joao-tecnico-chad/SCDTR-project/Distributed Controller/report/report_phase2.tex

\documentclass[10pt,twocolumn]{article}

\usepackage[utf8]{inputenc}
\usepackage[margin=1.8cm]{geometry}
\usepackage{graphicx}
\usepackage{amsmath,amssymb}
\usepackage{booktabs}
\usepackage{caption}
\usepackage{hyperref}
\usepackage{float}
\usepackage{enumitem}
\usepackage{array}
\usepackage{tikz}
\usetikzlibrary{arrows.meta,positioning,shapes.geometric,fit,calc,backgrounds,decorations.pathreplacing}

\setlength{\parindent}{0pt}
\setlength{\parskip}{0.5em}
\newcommand{\HRule}{\rule{\linewidth}{0.5mm}}

\begin{document}

\twocolumn[{%
\begin{center}
\vspace{0.5cm}
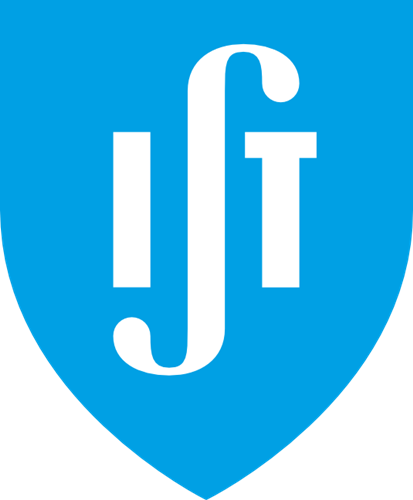
[picture p1: Local Luminaire Controller/report/IST_Logo.png]
\\[0.5cm]
\textsc{\Large Distributed Real-Time Control Systems}\\[0.4cm]
\textsc{\large Master's in Electrical and Computer Engineering}\\[0.6cm]
\HRule\\[0.2cm]
{\normalsize \bf Final Report --- Distributed Cooperative Illumination Control}\\[0.1cm]
\HRule\\[0.4cm]
\begin{minipage}{0.3\textwidth}
\centering
\emph{Author:}\\
Jo\~{a}o Rocha\\
\texttt{ist1106509}
\end{minipage}%
\begin{minipage}{0.3\textwidth}
\centering
\emph{Author:}\\
Ricardo Gaspar\\
\texttt{ist1104180}
\end{minipage}%
\begin{minipage}{0.3\textwidth}
\centering
\emph{Author:}\\
Diogo Costa\\
\texttt{ist1102632}
\end{minipage}\\[0.5cm]
{\small Instituto Superior T\'{e}cnico -- \today}
\vspace{0.6cm}
\end{center}
}]

% ===================================================================
\section{Introduction}

This report presents the distributed cooperative illumination system developed in Phase~2. Three smart luminaires communicate over CAN-BUS, automatically calibrate a linear model at start-up, and run distributed optimisation algorithms to minimise energy while maintaining desk illuminance above occupancy-dependent lower bounds. Compared with the local PI controller of Phase~1, this stage adds inter-node communication, cooperative decision-making, and a hub interface for PC control. Since each luminaire affects not only its own desk but also neighbouring desks through cross-coupling, the control problem is coupled and must be solved cooperatively.

% ===================================================================
\section{System Architecture}

Each node comprises an RP2040 Pico, an LED driven by 12-bit PWM (0--4095), an LDR-based luxmeter with a voltage-divider circuit (10\,k$\Omega$ fixed resistor), and an MCP2515 CAN controller interfaced via SPI at 10\,MHz. The MCP2515 modules use 16\,MHz crystals and are powered at 5\,V from the Pico VBUS pin; a common ground between all modules is essential. LEDs and sensors are mounted in 3D-printed fixtures that minimise external light seepage into the measurement area.

\begin{figure}[H]
\centering
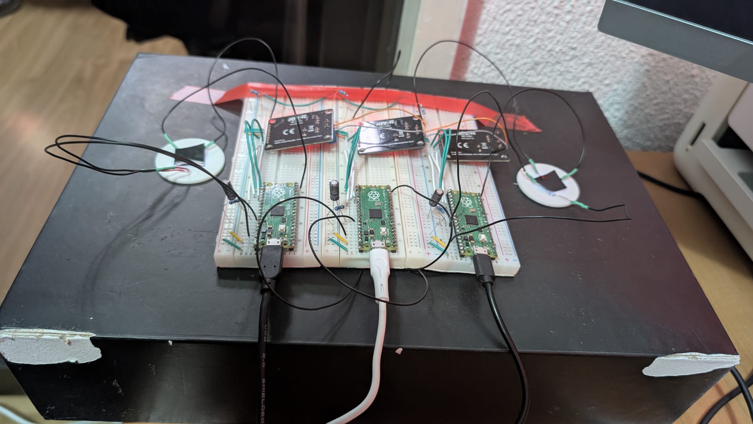
[picture p2: results/system_top.jpg]

\caption{Top view: Pico boards, MCP2515 modules, LDR sensors on 3D-printed mounts.}
\label{fig:photo_top}
\end{figure}

\begin{figure}[H]
\centering
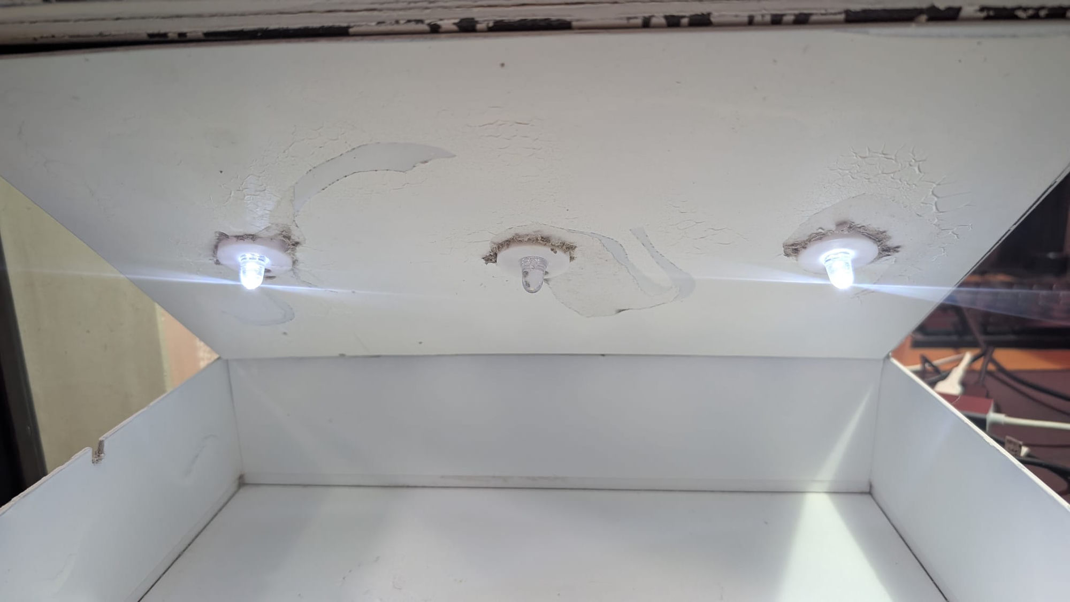
[picture p3: results/system_interior.jpg]

\caption{Interior: three LEDs in 3D-printed ceiling fixtures; white walls provide diffuse reflection.}
\label{fig:photo_interior}
\end{figure}

The RP2040 dual-core architecture separates concerns (Figure~\ref{fig:arch}): Core~0 runs the 100\,Hz PI loop, distributed algorithms, serial/hub interface, and calibration; Core~1 handles MCP2515 SPI exclusively, preventing bus contention.

\begin{figure}[H]
\centering
\begin{tikzpicture}[
  block/.style={rectangle, draw, rounded corners, minimum height=0.7cm, minimum width=2.2cm, font=\scriptsize, align=center},
  queue/.style={rectangle, draw, fill=yellow!20, minimum height=0.6cm, minimum width=1.6cm, font=\scriptsize\ttfamily},
  >=Stealth, node distance=0.4cm
]
  \node[block, fill=blue!10] (pi) {100\,Hz PI loop};
  \node[block, fill=blue!10, below=of pi] (admm) {Distributed\\algorithms};
  \node[block, fill=blue!10, below=of admm] (serial) {Serial / Hub /\\Calibration};
  \node[queue, right=1.2cm of pi] (txq) {can\_tx\_queue};
  \node[queue, right=1.2cm of admm] (rxq) {can\_rx\_queue};
  \node[queue, right=1.2cm of serial] (rdy) {core1\_ready};
  \node[block, fill=green!10, right=1.2cm of txq] (txd) {TX dequeue};
  \node[block, fill=green!10, right=1.2cm of rxq] (rxe) {RX enqueue};
  \node[block, fill=green!10, right=1.2cm of rdy] (irq) {CAN IRQ\\handler};
  \draw[->] (pi) -- (txq); \draw[->] (txq) -- (txd);
  \draw[->] (rxe) -- (rxq); \draw[->] (rxq) -- (admm);
  \draw[->] (serial) -- (rdy); \draw[->] (rdy) -- (irq);
  \node[above=0.15cm of pi, font=\footnotesize\bfseries] {Core 0};
  \node[above=0.15cm of txd, font=\footnotesize\bfseries] {Core 1};
  \begin{scope}[on background layer]
    \node[draw, dashed, rounded corners, inner sep=0.2cm, fit=(pi)(admm)(serial), fill=blue!3] {};
    \node[draw, dashed, rounded corners, inner sep=0.2cm, fit=(txd)(rxe)(irq), fill=green!3] {};
  \end{scope}
\end{tikzpicture}
\caption{Dual-core architecture. Cores communicate via lock-free Pico SDK queues.}
\label{fig:arch}
\end{figure}

This separation bounds CAN interrupt latency independently of control-loop computation time. Any USB-connected node acts as a hub, translating serial commands to CAN and routing replies back, allowing the complete network to be operated from a single terminal.

% ===================================================================
\section{CAN-BUS Communication}

The CAN bus operates at 500\,kbps with standard 11-bit identifiers, terminated with 120\,$\Omega$ resistors. The ID encodes message type plus sender/target: $\texttt{CAN\_ID} = \texttt{BASE} + \texttt{node\_id}$. Lower IDs win arbitration, so management traffic (Hello, 0x100) always preempts algorithm data (0x700+). Broadcasts use address \texttt{0x7F}. Table~\ref{tab:can} lists all ten message types.

\begin{table}[H]
\centering
\caption{CAN message types and identifiers.}
\resizebox{\columnwidth}{!}{%
\begin{tabular}{llll}
\toprule
Base ID & Type & Direction & Payload \\
\midrule
\texttt{0x100} & Hello & Broadcast & Heartbeat, peer discovery \\
\texttt{0x300} & Command & Unicast/Bcast & Duty, ref, occupancy, cost \\
\texttt{0x400} & Calibration & Broadcast & Plan params, slot sync \\
\texttt{0x500} & Query & Unicast & Request metric from peer \\
\texttt{0x580} & Reply & Unicast & Response to query \\
\texttt{0x600} & Stream & Broadcast & Real-time lux/duty/ref \\
\texttt{0x680} & Gain Exch. & Broadcast & $K$ row, $L_{\text{ref}}$, cost \\
\texttt{0x700} & Consensus & Broadcast & Duty proposals \\
\texttt{0x780} & ADMM & Broadcast & $z_i$, $u_i$, $d_i$ \\
\texttt{0x7C0} & Dual Dec. & Broadcast & $d_i$, $\lambda_i$ \\
\bottomrule
\end{tabular}%
}
\label{tab:can}
\end{table}

% ===================================================================
\section{Calibration}

At power-on, all nodes enter a discovery phase where they broadcast SYN frames and reply with ACK. A node exits wakeup only after the 5-second window expires, guaranteeing full reachability (Figure~\ref{fig:wakeup}). The coordinator (lowest node ID) then broadcasts the calibration plan.

\begin{figure}[H]
\centering
\begin{tikzpicture}[>=Stealth, every node/.style={font=\scriptsize}]
  \def\xa{0} \def\xb{1.8} \def\xc{3.6}
  \node[font=\scriptsize\bfseries] at (\xa,0) {Node 1};
  \node[font=\scriptsize\bfseries] at (\xb,0) {Node 2};
  \node[font=\scriptsize\bfseries] at (\xc,0) {Node 3};
  \draw[thick] (\xa,-0.25) -- (\xa,-4.8);
  \draw[thick] (\xb,-0.25) -- (\xb,-4.8);
  \draw[thick] (\xc,-0.25) -- (\xc,-4.8);
  \draw[->,blue] (\xa,-0.6) -- (\xb,-0.6) node[midway,above] {SYN};
  \draw[->,blue] (\xa,-0.75) -- (\xc,-0.75) node[midway,below] {SYN};
  \draw[->,red] (\xb,-1.15) -- (\xa,-1.15) node[midway,above] {ACK};
  \draw[->,red] (\xc,-1.3) -- (\xa,-1.3) node[midway,below] {ACK};
  \draw[->,blue] (\xb,-1.7) -- (\xc,-1.7) node[midway,above] {SYN};
  \draw[->,red] (\xc,-2.25) -- (\xb,-2.25) node[midway,above] {ACK};
  \draw[dashed, thick, gray] (\xa-0.4,-3.0) -- (\xc+0.4,-3.0);
  \node[right,gray,font=\scriptsize] at (\xc+0.5,-3.0) {$T_{\text{wake}}{=}5$\,s};
  \draw[->,orange,thick] (\xa,-3.8) -- (\xb,-3.8);
  \draw[->,orange,thick] (\xa,-3.8) -- (\xc,-3.8);
  \node[above,orange] at ({(\xa+\xc)/2},-3.8) {Calib Plan};
\end{tikzpicture}
\caption{Wake-up and calibration trigger sequence.}
\label{fig:wakeup}
\end{figure}

The system model is $\mathbf{L} = \mathbf{K}\mathbf{d} + \mathbf{o}$, where $\mathbf{K}$ is the gain matrix and $\mathbf{o}$ the background. Calibration measures these via round-robin: baseline (all LEDs off), then each LED at 50\% duty while all sensors record, yielding $K_{ji} = (L_j^{(i)} - o_j)/d_{\text{cal}}$. The state machine (Figure~\ref{fig:calib_sm}) completes in ${\sim}4150$\,ms.

\begin{figure}[H]
\centering
\begin{tikzpicture}[
  state/.style={rectangle, draw, rounded corners=4pt, minimum height=0.65cm, minimum width=1.5cm, font=\scriptsize, align=center, fill=blue!8},
  >=Stealth, node distance=0.3cm and 0.15cm, every edge/.style={draw, ->},
  timing/.style={font=\tiny, text=gray}
]
  \node[state] (idle) {IDLE};
  \node[state, below=0.5cm of idle] (wait) {WAIT\\START};
  \node[state, below=0.5cm of wait] (bsettle) {BASELINE\\SETTLE};
  \node[state, below=0.5cm of bsettle] (bmeas) {BASELINE\\MEASURE};
  \node[state, below=0.5cm of bmeas] (ssettle) {SLOT $i$\\SETTLE};
  \node[state, below=0.5cm of ssettle] (smeas) {SLOT $i$\\MEASURE};
  \node[state, below=0.5cm of smeas] (finish) {GAIN\\EXCHANGE};
  \draw[->] (idle) -- (wait) node[midway,right,timing] {plan received};
  \draw[->] (wait) -- (bsettle) node[midway,right,timing] {start time};
  \draw[->] (bsettle) -- (bmeas) node[midway,right,timing] {250\,ms};
  \draw[->] (bmeas) -- (ssettle) node[midway,right,timing] {600\,ms $\to$ $\mathbf{o}$};
  \draw[->] (ssettle) -- (smeas) node[midway,right,timing] {250\,ms};
  \draw[->] (smeas.east) -- ++(0.7,0) |- (ssettle.east) node[pos=0.25,right,timing] {$i{<}N$};
  \draw[->] (smeas) -- (finish) node[midway,right,timing] {$i{=}N$ $\to$ $\mathbf{K}$};
  \draw[decorate, decoration={brace, amplitude=4pt, mirror}, thick, gray]
    ($(bsettle.south west)+(-0.35,0)$) -- ($(smeas.south west)+(-0.35,0)$)
    node[midway, left=5pt, font=\tiny, gray, align=right] {$850 + N{\times}1100$\\$\approx 4150$\,ms};
\end{tikzpicture}
\caption{Calibration state machine.}
\label{fig:calib_sm}
\end{figure}

Model validation (Figure~\ref{fig:model}) confirms linearity with $R^2 = 0.977$, $0.990$, $0.993$ for nodes 1--3. The measured $\mathbf{K}$ and $\mathbf{o}$ are in Table~\ref{tab:K}. The diagonal elements are dominant, confirming each LED primarily lights its own desk. Off-diagonal coupling is moderate between adjacent nodes ($K_{12}{=}12.53$, $K_{23}{=}11.66$) but weak for non-adjacent pairs ($K_{31}{=}1.31$).

\begin{figure}[H]
\centering
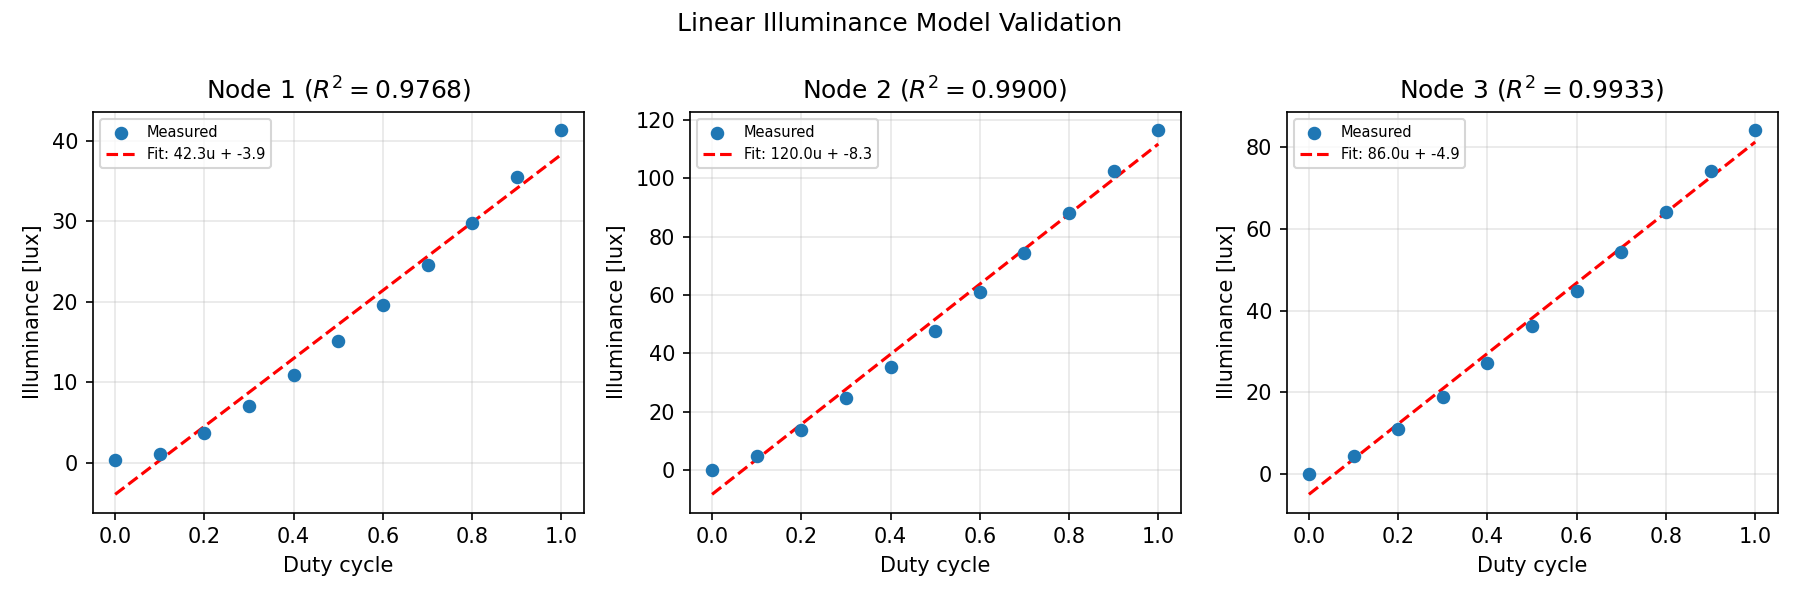
[picture p4: results/model_validation.png]

\caption{Model validation: lux vs.\ duty with linear fit and $R^2$.}
\label{fig:model}
\end{figure}

\begin{table}[H]
\centering
\caption{Gain matrix $\mathbf{K}$ (lux/duty) and background $\mathbf{o}$ (lux).}
\begin{tabular}{c|ccc|c}
\toprule
 & Node 1 & Node 2 & Node 3 & $o_i$ \\
\midrule
Node 1 & 29.50 & 12.53 & 4.03 & 0.32 \\
Node 2 & 4.01 & 95.04 & 11.66 & 0.23 \\
Node 3 & 1.31 & 9.09 & 72.23 & 0.03 \\
\bottomrule
\end{tabular}
\label{tab:K}
\end{table}

% ===================================================================
\section{Local Controller}

Each node runs a discrete PI controller with feedforward at 100\,Hz (10\,ms period). The feedforward term $u_{\text{ff}} = (L_{\text{ref}} - o_i)/K_{ii}$ inverts the calibrated model to provide an immediate open-loop duty estimate, enabling single-cycle reference tracking. The PI component ($K_p{=}0.5$, $K_i{=}0.3$) corrects residual errors from model mismatch and external disturbances. Back-calculation anti-windup prevents integrator saturation when the duty cycle is clamped at 0 or 1.

% ===================================================================
\section{Distributed Algorithms}

The optimisation problem minimises total weighted energy $\sum c_i d_i$ subject to illuminance constraints $\mathbf{K}\mathbf{d} + \mathbf{o} \geq \mathbf{L}_{\text{ref}}$ and duty bounds $0 \leq d_i \leq 1$, where $c_i$ is the cost coefficient for luminaire~$i$. Three distributed algorithms were implemented and compared against the local PI baseline:

\textbf{Consensus ADMM.} Each node $i$ solves $\min c_i d_i + (\rho/2)(d_i - \bar{d}_i)^2$ subject to all $N$ illuminance constraints, checking that its proposed duty satisfies not only its own constraint but also the constraints of all peers. Proposals are exchanged via CAN and averaged until convergence ($\rho{=}2.0$, $k_{\max}{=}50$).

\textbf{ADMM.} The Alternating Direction Method of Multipliers decomposes into a primal update $d_i = z_i - u_i - c_i/\rho$, a feasibility projection $\mathbf{z} = \Pi_{\mathcal{C}}(\mathbf{d}+\mathbf{u})$ via iterative Dykstra projections, and a dual update $u_i \mathrel{+}= d_i - z_i$ ($\rho{=}1.0$).

\textbf{Dual Decomposition.} Lagrangian relaxation with subgradient ascent on the dual variables. The step size $\alpha_0{=}0.05$ decays geometrically (factor 0.995) to ensure convergence.

% ===================================================================
\section{Results}

\subsection{Algorithm Comparison}

Three metrics are computed at each 10\,ms cycle: \emph{energy} (accumulated power$\times$time), \emph{visibility error} (average illuminance deficit below reference), and \emph{flicker} (duty-cycle direction reversals). A dedicated \texttt{RM} command resets all accumulators, enabling fair per-algorithm comparison.

All four algorithms were tested with equal costs $c{=}[1,1,1]$, $L_{\text{ref}}{=}20$\,lux, and metrics reset before each 20-second window. All converge to the same operating point (Table~\ref{tab:equal}), confirming the unique feasible minimum. Visibility error is below 0.026\,lux, flicker is ${\sim}0.0003$\,s$^{-1}$ in steady state (negligible duty-cycle oscillation), and total energy is ${\sim}28.3$\,J. Consensus proved most robust during testing; ADMM and dual decomposition showed sensitivity to rapid algorithm switching.

\begin{table}[H]
\centering
\caption{Algorithm comparison, equal costs (20\,s window).}
\resizebox{\columnwidth}{!}{%
\begin{tabular}{l|ccc|ccc|c}
\toprule
 & \multicolumn{3}{c|}{Duty cycle} & \multicolumn{3}{c|}{Energy [J]} & Vis.~err \\
Algorithm & N1 & N2 & N3 & N1 & N2 & N3 & (max) \\
\midrule
PI Only    & 0.511 & 0.168 & 0.267 & 12.73 & 5.32 & 10.22 & 0.025 \\
Consensus  & 0.520 & 0.169 & 0.268 & 12.88 & 5.30 & 10.23 & 0.024 \\
ADMM       & 0.527 & 0.169 & 0.269 & 13.14 & 5.31 & 10.27 & 0.026 \\
Dual Dec.  & 0.516 & 0.170 & 0.269 & 13.14 & 5.32 & 10.23 & 0.024 \\
\bottomrule
\end{tabular}%
}
\label{tab:equal}
\end{table}

\begin{figure}[H]
\centering
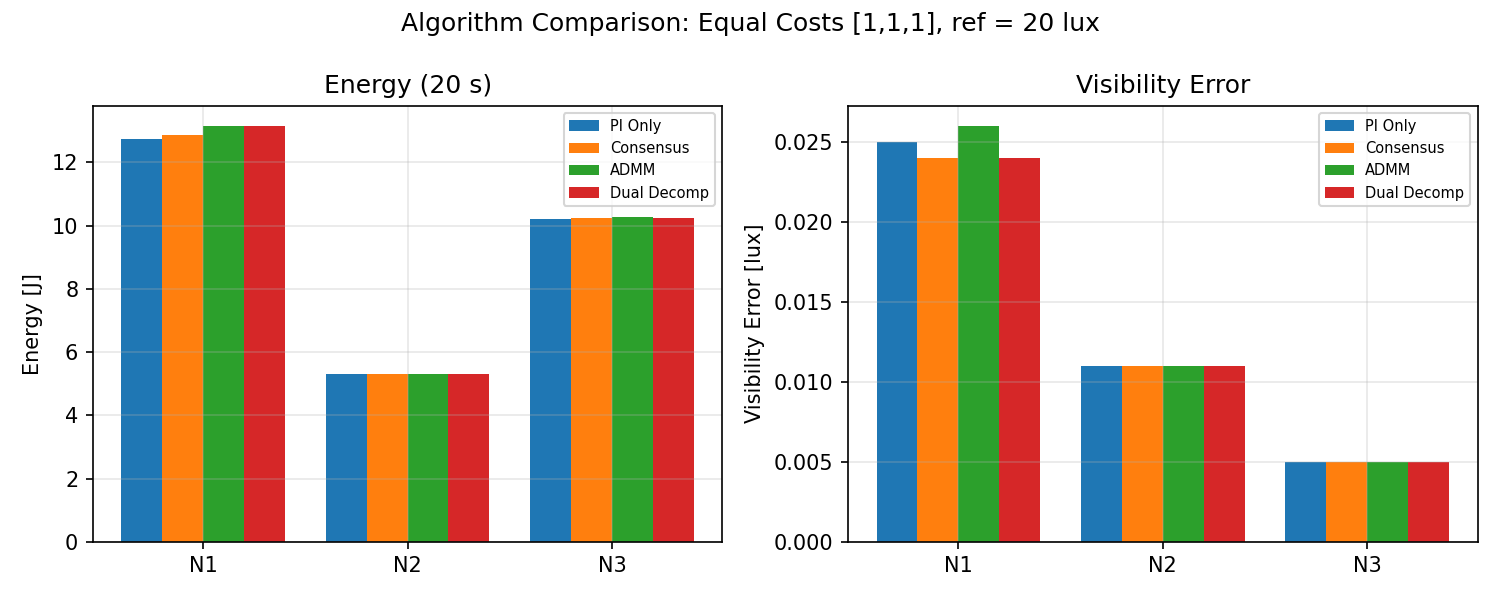
[picture p5: results/alg_comparison_equal.png]

\caption{Energy and visibility error across algorithms.}
\label{fig:equal}
\end{figure}

\subsection{Unequal Costs}

With $c{=}[1,2,3]$, the consensus algorithm should shift duty towards the cheapest node. However, cross-coupling gains are 7--70$\times$ weaker than self-gains (e.g., $K_{21}/K_{22} = 0.042$), so each node must provide most of its own illuminance. The resulting duty change is marginal ($<$2\%, Table~\ref{tab:unequal})---a physical limitation of the box geometry, not an algorithm deficiency.

\begin{table}[H]
\centering
\caption{Duty: equal vs.\ unequal costs (Consensus).}
\begin{tabular}{l|ccc}
\toprule
Cost setting & N1 & N2 & N3 \\
\midrule
Equal $[1,1,1]$   & 0.520 & 0.169 & 0.268 \\
Unequal $[1,2,3]$ & 0.530 & 0.168 & 0.270 \\
\bottomrule
\end{tabular}
\label{tab:unequal}
\end{table}

\begin{figure}[H]
\centering
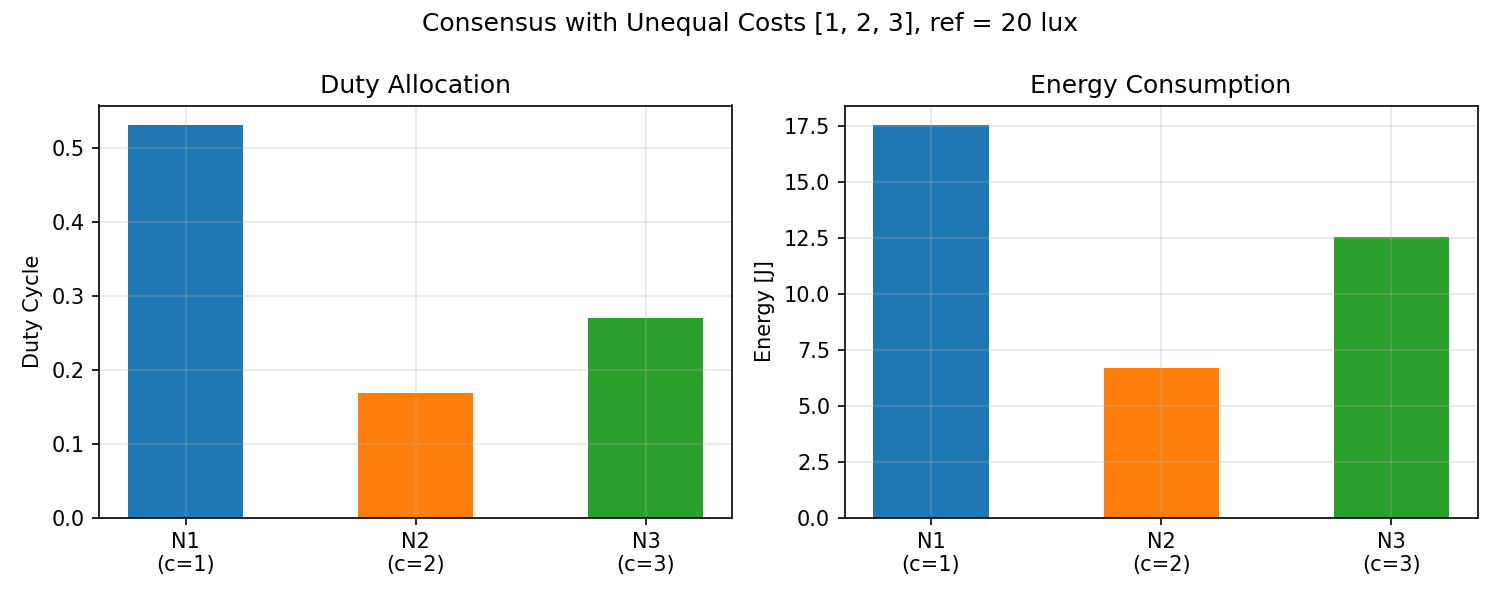
[picture p6: results/duty_unequal_costs.png]

\caption{Consensus duty and energy with $c{=}[1,2,3]$.}
\label{fig:unequal}
\end{figure}

\subsection{Step Response and Occupancy}

Figure~\ref{fig:step} shows Node~1's response to a 5$\to$25\,lux reference step. The feedforward term provides an immediate duty jump; the measured illuminance reaches the target within the first control cycle (${\sim}10$\,ms). Figure~\ref{fig:occ} shows occupancy-driven transitions (LOW$\to$HIGH$\to$LOW), tracked with the same single-cycle speed.

\begin{figure}[H]
\centering
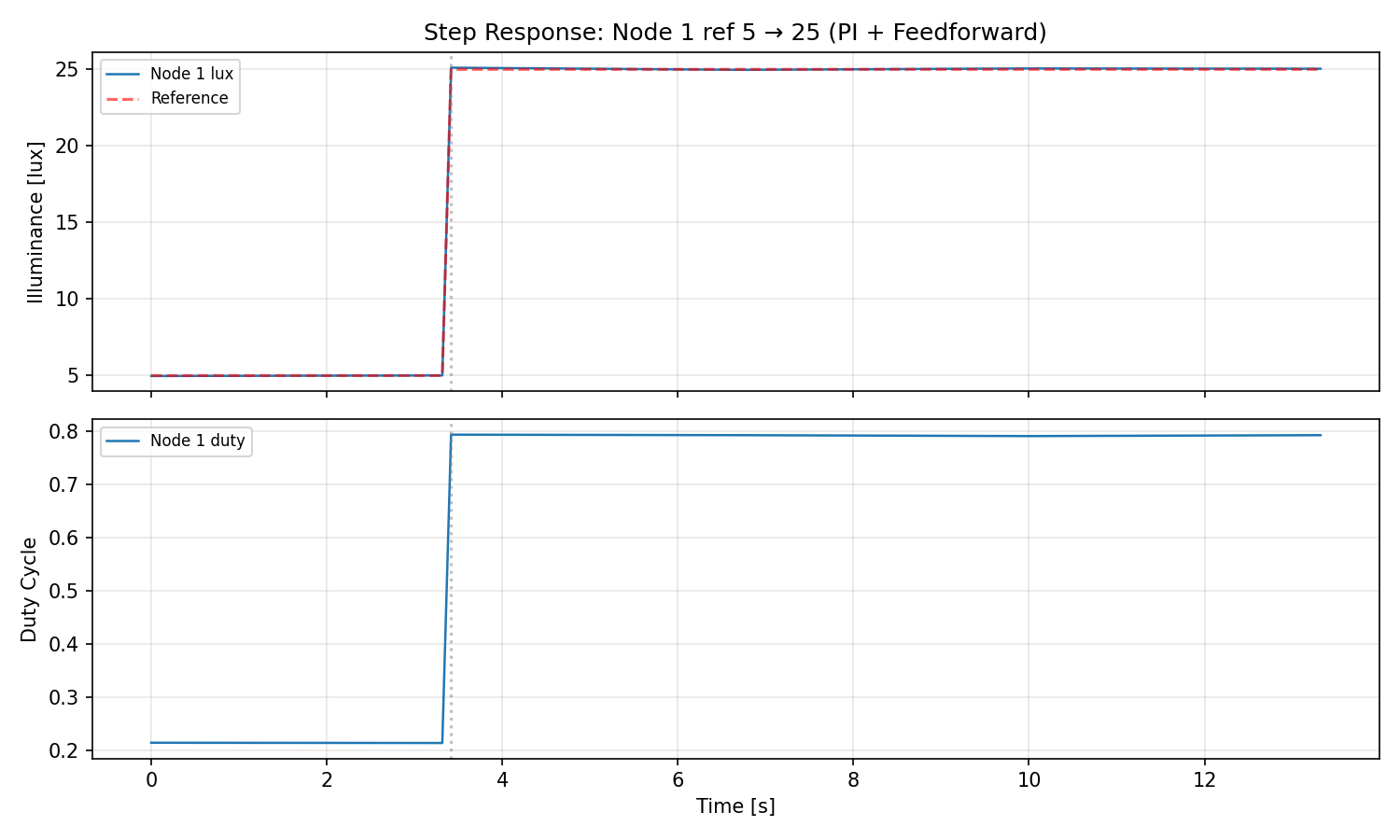
[picture p7: results/step_response_ff.png]

\caption{Step response: Node~1 ref 5\,$\to$\,25\,lux.}
\label{fig:step}
\end{figure}

\begin{figure}[H]
\centering
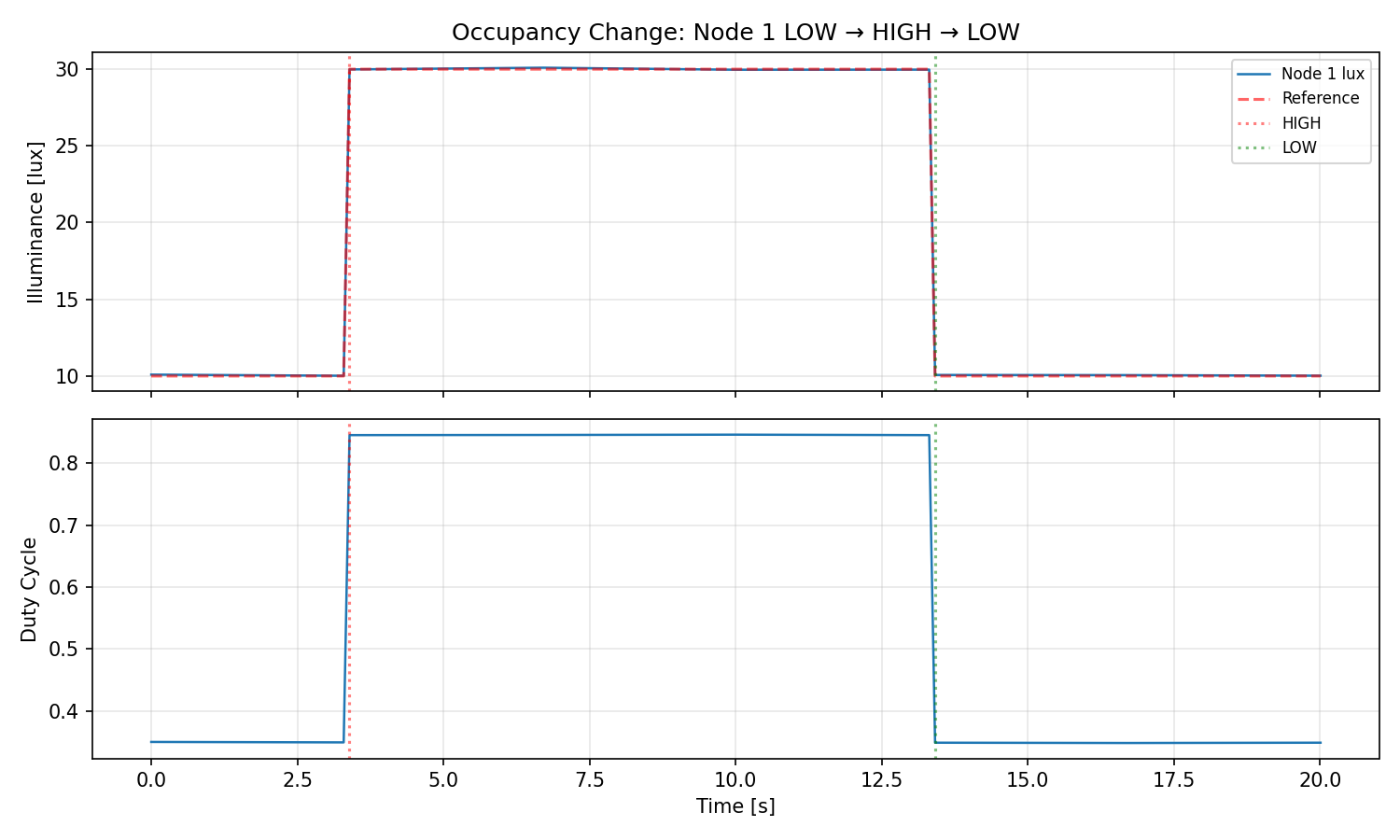
[picture p8: results/occupancy_change.png]

\caption{Occupancy change: Node~1 LOW\,$\to$\,HIGH\,$\to$\,LOW.}
\label{fig:occ}
\end{figure}

\subsection{Disturbance Rejection}

Two disturbance tests were performed. In the physical test (Figure~\ref{fig:dist}), opening and closing the box lid causes light to escape; all three nodes maintain 20\,lux within 1\,lux throughout. In the programmatic test (Figure~\ref{fig:dist_prog}), Node~2's duty was forced to 0.8 open-loop. Node~2's cross-illumination raises Node~1's lux, so Node~1's PI controller reduces duty from 0.52 to 0.15 (70\% reduction) to maintain the target. When feedback is restored, recovery occurs within one polling sample ($<$1.3\,s resolution); the actual PI recovery is sub-second.

\begin{figure}[H]
\centering
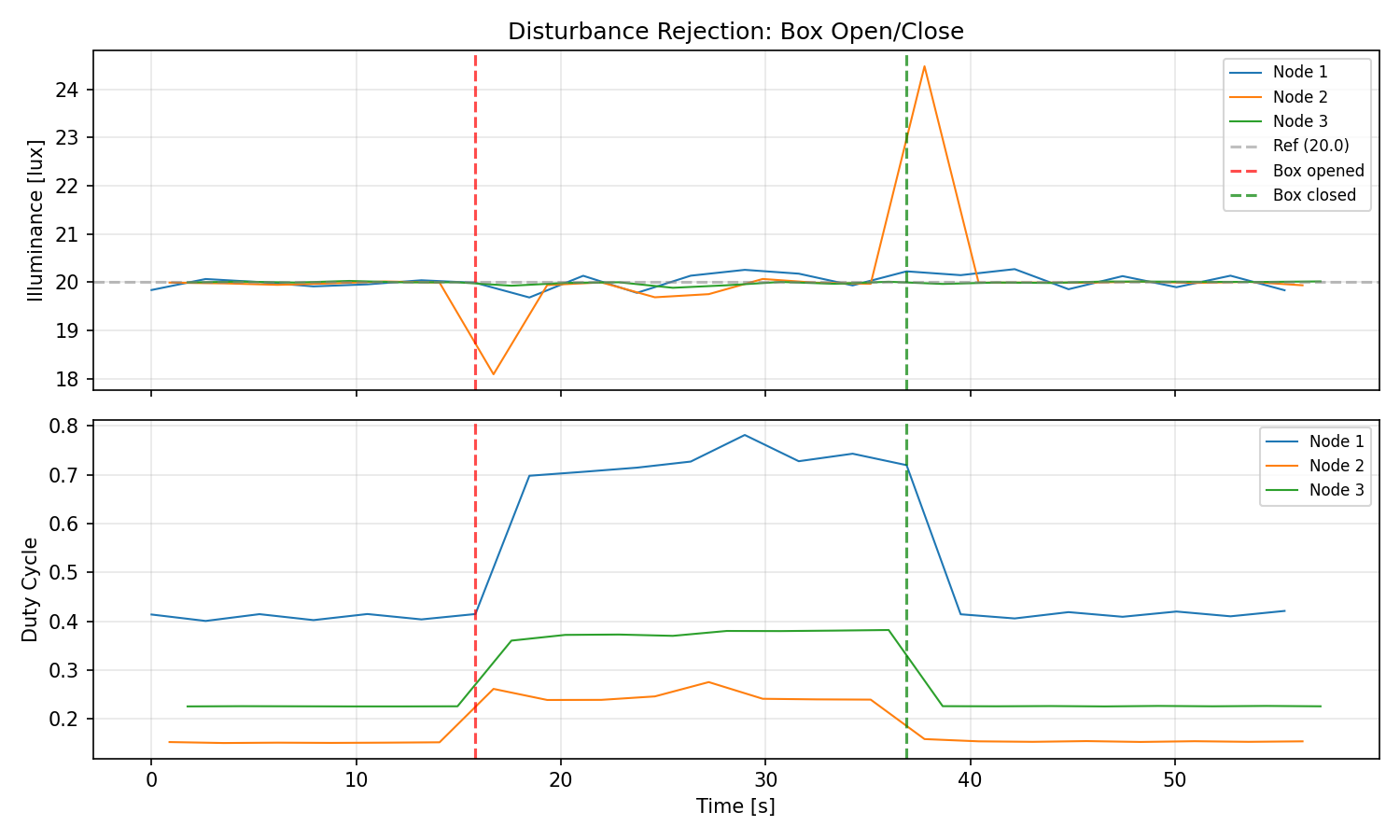
[picture p9: results/disturbance_rejection.png]

\caption{Physical disturbance: box opened (red) and closed (green).}
\label{fig:dist}
\end{figure}

\begin{figure}[H]
\centering
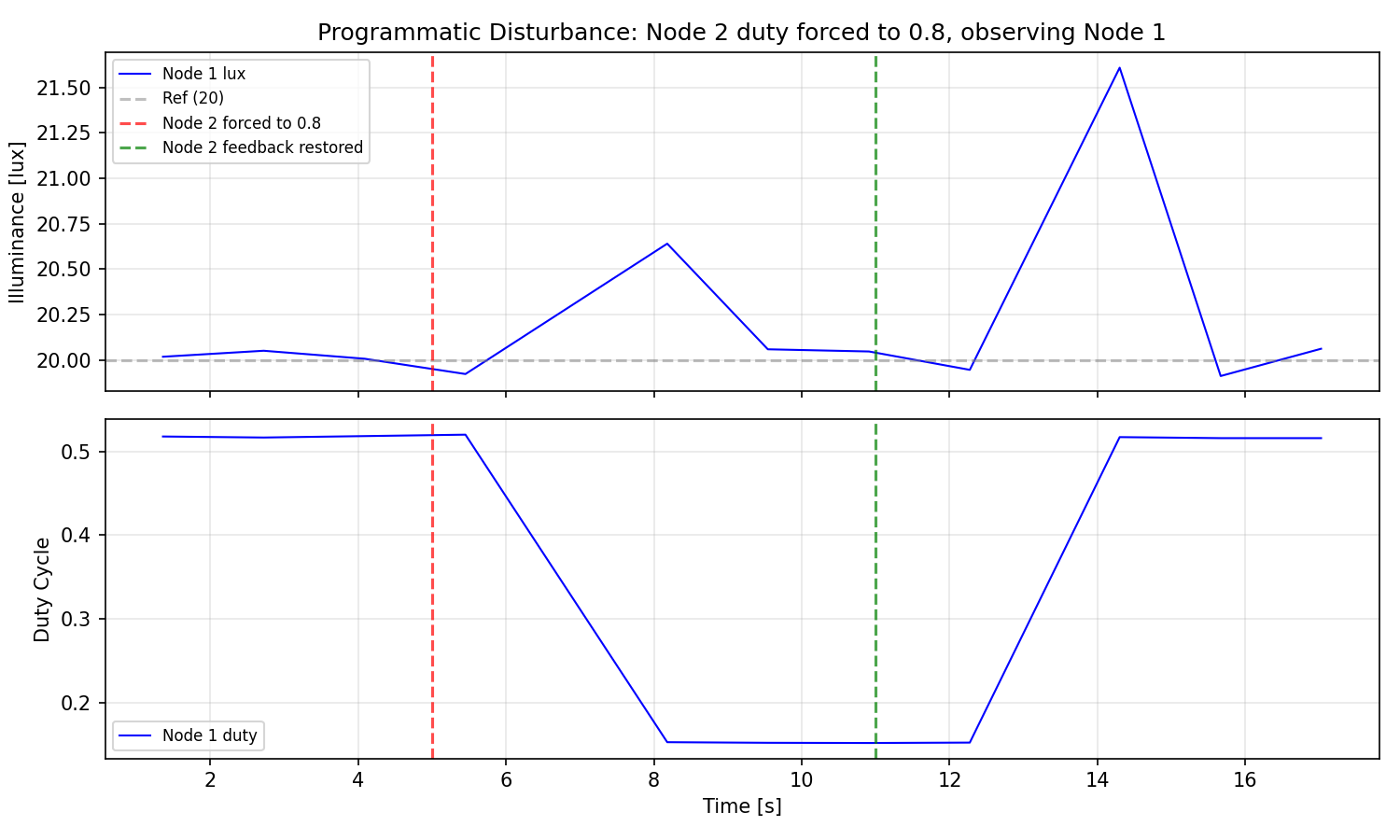
[picture p10: results/disturbance_programmatic.png]

\caption{Programmatic disturbance: Node~2 forced to 0.8, Node~1 compensates.}
\label{fig:dist_prog}
\end{figure}

% ===================================================================
\section{Conclusions}

The system achieves all Phase~2 objectives: 500\,kbps CAN communication, hub-based PC control, deterministic wake-up, automated calibration (${\sim}4.2$\,s), and distributed cooperative control. The PI controller with feedforward provides sub-100\,ms reference tracking and effective disturbance rejection. Three optimisation algorithms were implemented and validated: with equal costs all converge to the same feasible point; with unequal costs, redistribution is limited by the weak physical cross-coupling (each LED dominates its own sensor by 7--70$\times$). Key design choices include: (i)~Core~1 exclusively for CAN, eliminating SPI contention; (ii)~feedforward initialisation for single-cycle tracking; (iii)~CAN-broadcast calibration plans for deterministic synchronisation; (iv)~full-constraint checking in the local optimisation, where each node considers all peers' illuminance requirements.

\end{document}
