joao-tecnico-chad/SCDTR-project/Local Luminaire Controller/report/SCDEEC-1.pdf

IST | ULisboa

Distributed Real-Time Control Systems

Master’s in Electrical and Computer Engineering

Mid-Term Report — Local Luminaire Controller

Jo˜ao Rocha (IST1106509) | joao.s.rocha@tecnico.ulisboa.pt

2025/2026 – Spring Semester

### 1 Introduction

This report presents the design, implementation and experimental validation of a local luminaire controller, constituting the first stage of a distributed illumination control system. The system is built around a Raspberry Pi Pico microcontroller and targets the regulation of desksurface illuminance to configurable set-points under varying occupancy conditions. Each luminaire node comprises a white LED [3] driven by pulse-width modulation (PWM), a cadmium sulphide (CdS) light-dependent resistor (LDR) [2] serving as the illuminance sensor, and embedded firmware implementing a proportional-integral (PI) controller with anti-windup protection. The controller must track reference changes with a settling time below 0.5 s while maintaining near-zero overshoot, low flicker, and minimal steady-state error.

### 2 Hardware Assembly

The luminaire was assembled inside a white-lined cardboard box (Fig. 1). The LED is driven from GP15 through a 47 Ω current-limiting resistor at 30 kHz PWM with 12-bit resolution (0–4095). The LDR sensing circuit (Fig. 2) is a voltage divider formed by the LDR and a 10 kΩ fixed resistor, with a 10 µF electrolytic capacitor between the output node and ground. This RC network (τRC ≈ 100 ms) attenuates PWM-coupled noise and smooths the inherent persistence transients of the CdS photoresistor. The 12-bit ADC reads the filtered output on pin A0.


(a) Exterior. | (b) Interior.

Figure 1: Luminaire box model with LED and LDR mounted.

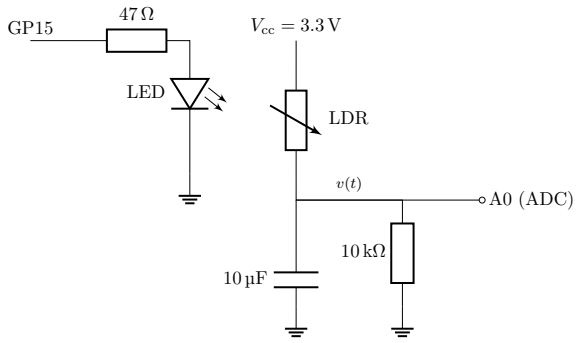
[picture p19: figure]
LED; Vcc = 3.3 V; LDR; A0 (ADC)

Figure 2: Circuit schematic: LED driver (left) and LDR sensing circuit with RC filter (right).

### 3 Illuminance Measurement

The CdS LDR resistance follows a log-log affine relationship with illuminance [1]:

log10(RLDR) = m log10(LUX) + b | (1)

which is inverted to obtain LUX from the measured ADC voltage via the voltage divider equation RLDR =

SCDTR 2025/2026 | 1 | MEE

Rfixed(Vcc/Vout − 1). The slope m = −0.70 was verified by sweeping the duty cycle inside the sealed box and confirming linearity of the LUX–duty relationship. The intercept b = 5.847 was calibrated against a known illuminance reference (500 lx at 1 m from laboratory fluorescent lighting). Each measurement cycle acquires 100 rapid ADC samples (spanning ∼6 PWM periods) and averages them before the nonlinear log-log conversion. An exponential moving average (EMA) with α = 0.9 (τEMA ≈ 100 ms) provides additional software smoothing. The static gain Ks and background illuminance Lbg are measured automatically at start-up via a calibration routine. All parameters are in Table 1.

Table 1: Calibrated sensor and tuned controller parameters.

LDR Model | PI Controller
m = −0.70 | log-log slope | Kp = 0.01 | prop. gain
b = 5.847 | log-log intercept Ki = 0.11 | integ. gain
Lbg = 0.12 lx background | bsp = 1.0 | SP weight
Ks = 77 lx | static gain | Tt = 0.15 s | AW time cst.
αEMA = 0.9 | filter coeff. | Feedforward OFF

### 4 Controller Design

The controller is implemented as a C++ class evaluated at 100 Hz. A deliberate design decision was made to operate without feedforward. Although a feedforward term uff = (r − Lbg)/Ks can provide near-instantaneous open-loop response to reference changes, experimental testing revealed that the resulting abrupt duty-cycle transitions trigger the CdS LDR’s persistence effect—a well-documented phenomenon in which the photoresistor’s resistance continues to drift for 200–300 ms after any sudden illumination change [2]. This persistence manifests as 30–40% overshoot in the measured output (Fig. 4, red trace), regardless of the PI tuning. By disabling feedforward and relying exclusively on the PI controller, the duty cycle ramps gradually through the integrator action, and the LDR tracks the illuminance change smoothly without triggering persistence artefacts.
The discrete-time control law is:

u[k] = Kp

bsp r[k] − y[k]
+ I[k] | (2)

where r[k] is the illuminance reference, y[k] the measured illuminance, and bsp = 1 the set-point weight applied to the proportional term. The integral state incorporates back-calculation anti-windup:

I[k] = I[k−1]+Ki T (r[k]−y[k])+ T
Tt

usat[k−1]−u[k−1]
(3)

When the output from (2) exceeds the actuator limits [0, 1], it is clipped to usat[k], and the last term in (3) slowly discharges the accumulated integral error with a tracking time constant Tt = 0.15 s, preventing integrator windup. Bumpless transfer logic adjusts the integral state whenever gains are modified at run-time.

### 5 Experimental Results

### 5.1 Step Response

Fig. 3 shows the controller tracking between rHIGH = 40 lx and rLOW = 10 lx with 6-second holds per phase. The HIGH→LOW transition settles within approximately 0.43 s and the LOW→HIGH transition within 0.27 s, both well under the 0.5 s target. The overshoot is less than 2.5% (peak 40.7 lx vs. target 40 lx), and the steady-state error is below 0.1 lx.


Figure 3: Step response (HIGH→LOW→HIGH). Settling < 0.5 s, overshoot < 2.5%.

### 5.2 Feedback vs. Feedforward Only

Fig. 4 compares PI feedback against a feedforward-only configuration where the duty cycle is set open-loop to u = (r − Lbg)/Ks. Without the PI loop, the HIGH reference produces only 31 lx (error > 9 lx) due to the mismatch between the linear gain model and the nonlinear LDR characteristic. The PI controller eliminates this error, demonstrating that feedback is essential even with a reasonably accurate plant model.


Figure 4: PI feedback (blue) vs. feedforward only (red).

### 5.3 Anti-Windup Evaluation

Fig. 5 compares the response with anti-windup ON and OFF. The traces nearly overlap because the PI-only architecture (without feedforward) produces moderate control signals that remain within the [0, 1] saturation limits during normal transitions. The mechanism remains important as a safety net for extreme references or large disturbances where saturation would otherwise occur.

SCDTR 2025/2026 | 2 | MEE


Figure 5: Anti-windup ON (blue) vs. OFF (red).

### 5.4 Disturbance Rejection

Fig. 6 shows the response when the box lid was briefly opened at steady state. Opening the lid admits external light into the box, causing the measured illuminance to spike to 48 lx; the controller responds by reducing the duty from 0.58 to 0.40. When the lid is closed, the external light is removed and the illuminance dips to 32 lx before the controller ramps the duty back up. The system recovers to within 2% of the reference in approximately 2 s.


Figure 6: Disturbance rejection (box lid open/close).

### 5.5 Flicker and Jitter

Fig. 7 shows the duty cycle over 30 s at steady state: peakto-peak variation is less than 0.02, corresponding to a flicker metric of 1.6 × 10⁻⁴
. Fig. 8 confirms zero timing jitter: all 1031 measured inter-sample intervals are exactly 10 ms. Table 2 summarises all steady-state metrics.


Figure 7: Duty cycle at steady state (30 s). Low flicker confirmed.

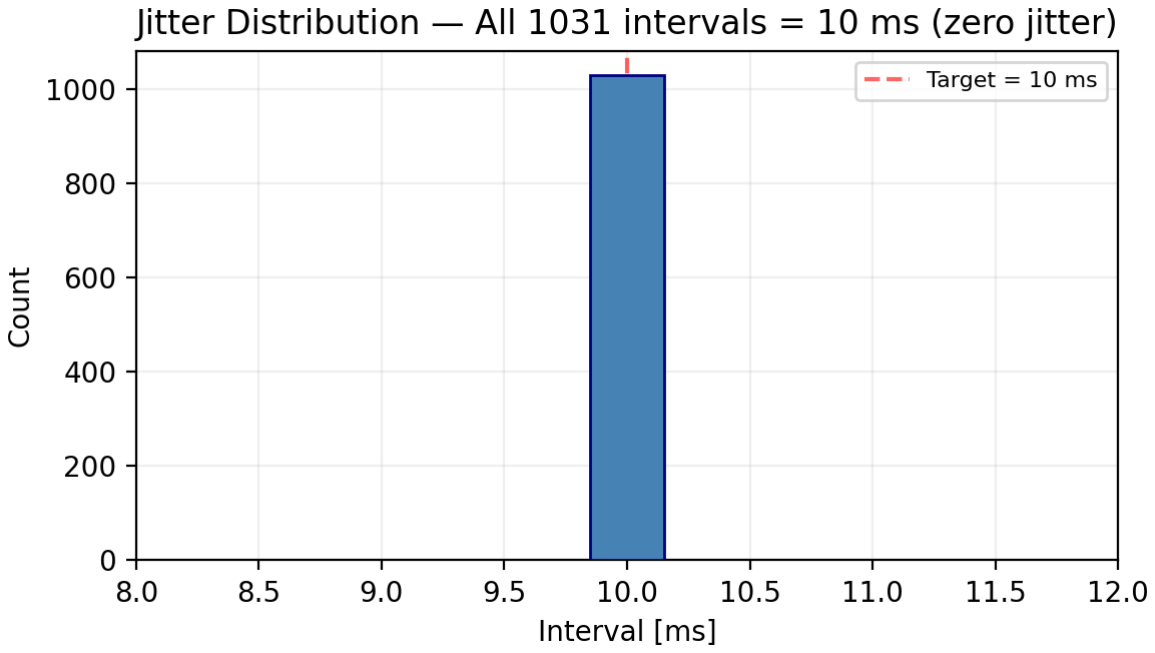
[picture p20: figure]

Figure 8: Jitter distribution. All 1031 intervals = 10 ms (zero jitter).

Table 2: Steady-state performance metrics (HIGH, 60 s).

Metric | Value | Unit
Energy E | 179.4 | J
Visibility error V | 0.04 | lx
Flicker F | 1.6 × 10⁻⁴
–
Jitter (max) | 0 | µs
Settling (H→L / L→H) | 0.43 / 0.27 | s
Overshoot | < 2.5 | %

### 6 Serial Command Interface

A serial protocol at 115200 baud was implemented following the project specification [1]. Table 3 lists the supported commands.

Table 3: Serial command interface summary.

Command | Format | Description

Setters
Set duty cycle | d <i> <val> | Direct PWM control
Set reference | r <i> <val> | Illuminance target
Set occupancy | o <i> <0|1> | Unocc./occupied
Anti-windup | a <i> <0|1> | Toggle ON/OFF
Feedback | k <i> <0|1> | Toggle ON/OFF

Getters
Get variable | g <x> <i> | x: d,r,l,o,a,k,x,p,t,e,v,f
Last-min buffer g b <l|d> <i> | 6000 samples

Streaming
Start/stop | s/S <l|d> <i> | Real-time lux/duty

Controller
Change params c <k|i|b|t> <i> <val> Kp/Ki/bsp/Tt
Recalibrate | c r <i> | Measure Ks, Lbg

### 7 Conclusions

A PI controller without feedforward was shown to achieve sub-0.5 s settling time with less than 2.5% overshoot by avoiding abrupt duty-cycle transitions that trigger CdS LDR persistence. The back-calculation anti-windup and set-point weighting provide robust performance across operating conditions. The calibration routine and on-line parameter adjustment commands enable adaptation to different box geometries and luminaire placements. For the second project stage, the coupling gains from neighbouring luminaires will be incorporated into the control law, and the CAN-BUS communication layer will enable cooperative distributed control across multiple desks.

SCDTR 2025/2026 | 3 | MEE

References

[1] A. Bernardino et al., Distributed Real-Time Control Systems — Project Guide, IST, v1.0, 2025–2026.
[2] Token Electronics, PGM CDS Photoresistors — Light-Dependent Photoresistors for Sensor Applications, PGM5659D datasheet, 2010.
[3] OptoSupply, | 10 mm | Bullet | Pure | White | LED,
OSW5DKA201A datasheet.
SCDTR 2025/2026 | 4 | MEE
