joao-tecnico-chad/SCDTR-project/results/cost_comparison.png

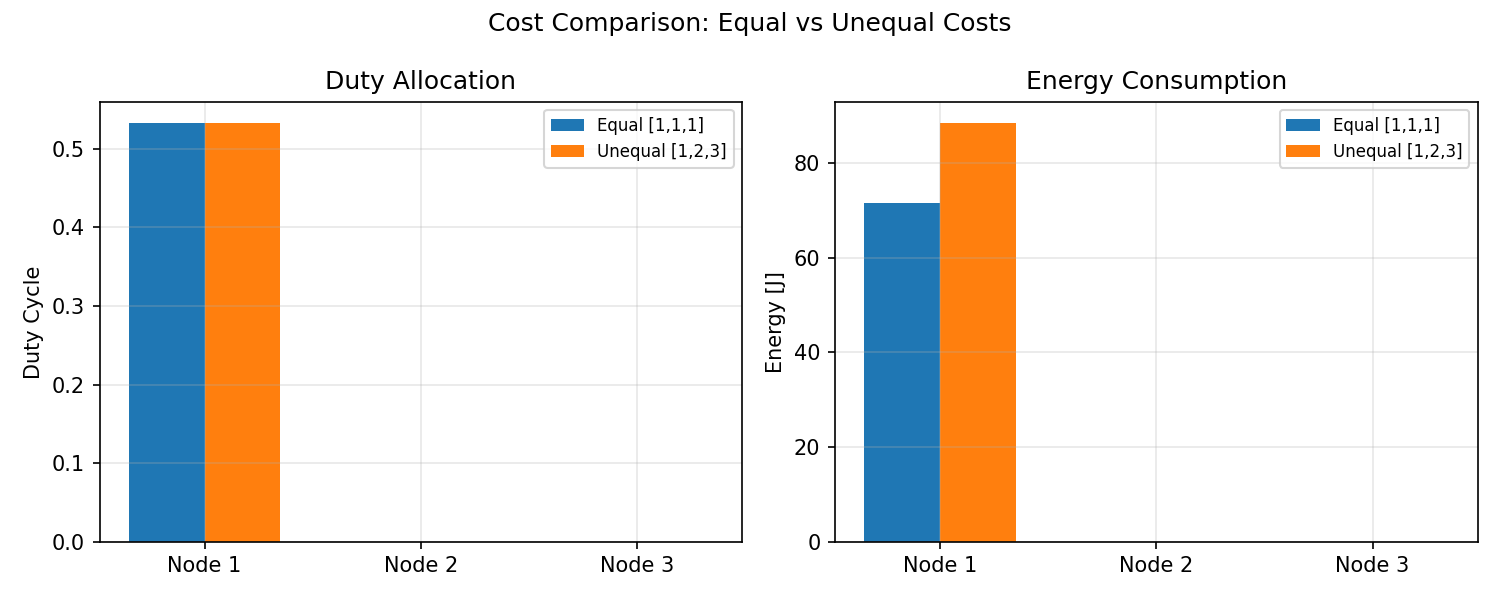
results/cost_comparison.png
