joao-tecnico-chad/SCDTR-project/Distributed Controller/docs/wiring_guide.pdf

# SCDTR Phase 2 — Wiring Guide

Distributed Cooperative Illumination System — 3 Luminaires + CAN-BUS Network

## 1. Components Required (per group of 3 students)

3x | RPI Pico W microcontrollers with GPIO headers
3x | Breadboards (small)
3x | MCP2515 Joy-It CAN-BUS modules (with termination jumpers)
3x | LED 10mm (85000-100000 mcd)
3x | LDR (light-dependent resistor)
3x | 47 Ohm resistor (LED current limiting)
3x | 10 kOhm resistor (LDR voltage divider)
3x | 10 uF capacitor (LDR filter)
3x | 8-wire male-female jumper sets (Pico to MCP2515)
2x | Wires for CAN-BUS line (twisted pair recommended)
1x | USB cable (for hub node to PC connection)
1x | Shoe box (opaque, white-lined interior)

## 2. Network Topology

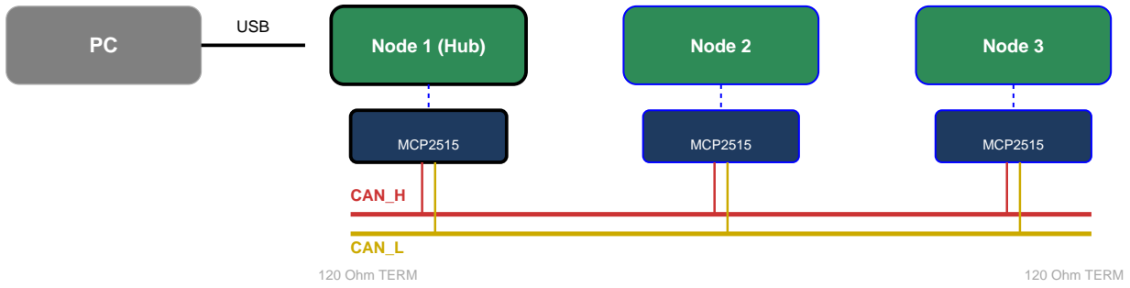
[picture p25: figure]
USB; Node 1 (Hub); MCP2515; Node 2; Node 3; CAN_H; CAN_L; 120 Ohm TERM

### Key Points:

- All 3 Picos run IDENTICAL firmware. The hub auto-detects via USB serial.
- CAN-BUS requires 120 Ohm termination at BOTH ends of the bus.
- The Joy-It MCP2515 modules have built-in termination jumpers — enable on the 2 end nodes.
- The middle node should have its termination jumper REMOVED.
- Use twisted pair wire for CAN_H and CAN_L to reduce noise.
- Each Pico connects to its MCP2515 via SPI (8 wires).
- The LED + LDR circuit is the same as Phase 1 (see next page).

## 3. Pico to MCP2515 SPI Wiring (per node)

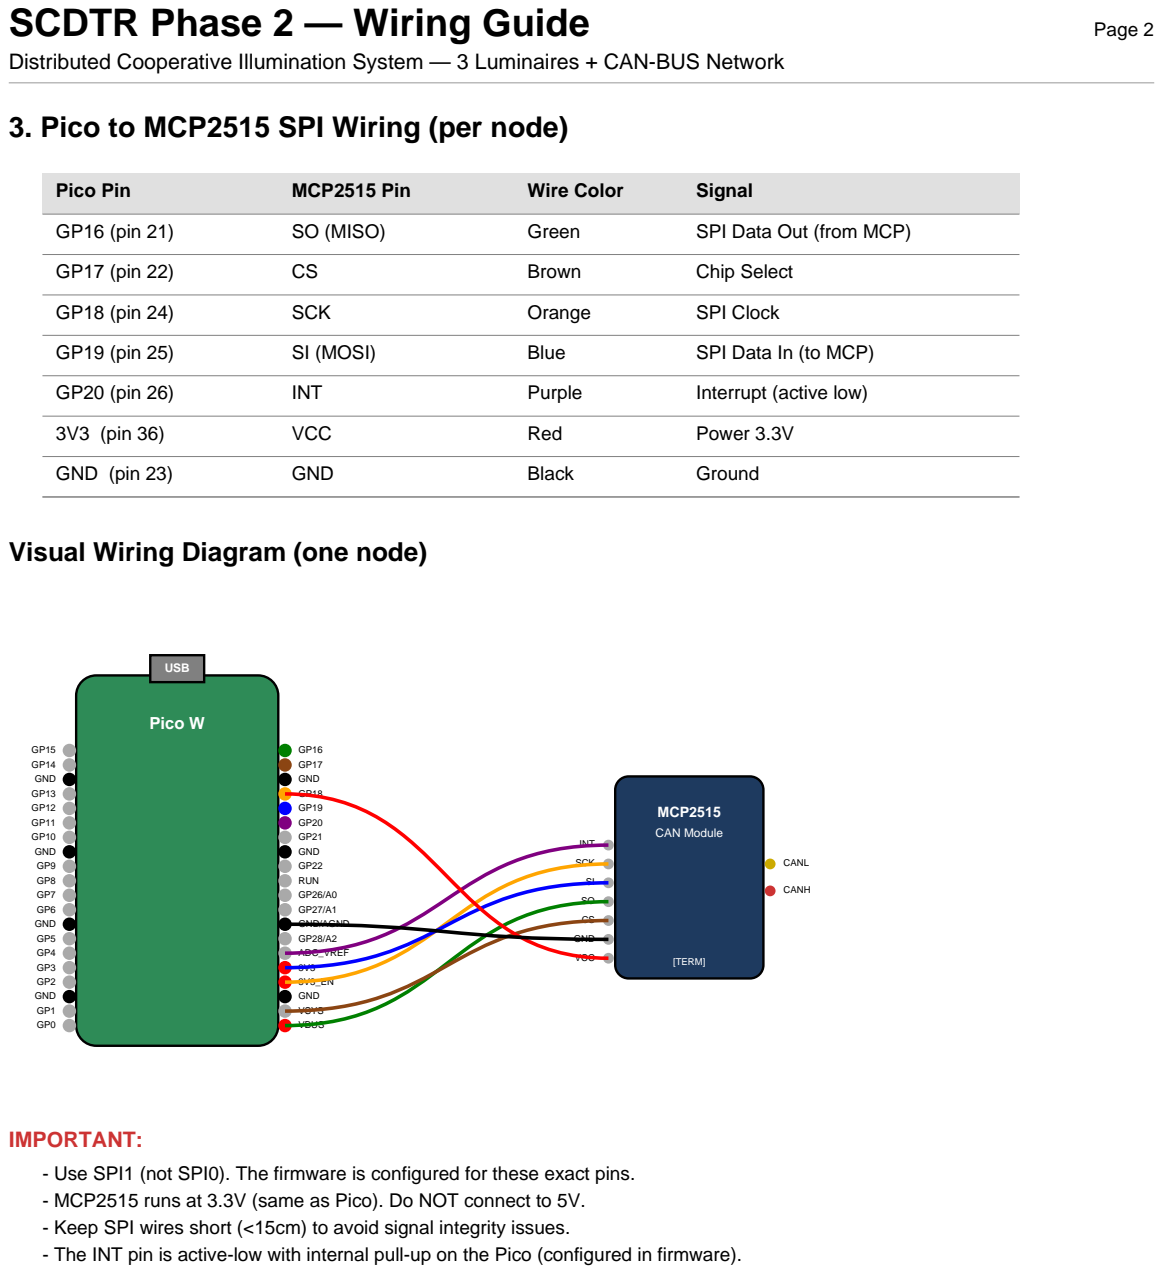
[picture p26: page 2]
Pico Pin; MCP2515 Pin; Wire Color; Signal; GP16 (pin 21); SO (MISO); Green; SPI Data Out (from MCP); GP17 (pin 22); Brown; Chip Select; GP18 (pin 24); SCK; Orange; SPI Clock; GP19 (pin 25); SI (MOSI); Blue; SPI Data In (to MCP); GP20 (pin 26); INT; Purple; Interrupt (active low); 3V3 (pin 36); VCC; Red; Power 3.3V; GND (pin 23); GND; Black; Ground; USB; Pico W; VBUS; VSYS; ADC_VREF; GND/AGND; RUN; MCP2515; CAN Module; CANH; CANL; [TERM]

Visual Wiring Diagram (one node)

IMPORTANT:
- Use SPI1 (not SPI0). The firmware is configured for these exact pins.
- MCP2515 runs at 3.3V (same as Pico). Do NOT connect to 5V.
- Keep SPI wires short (<15cm) to avoid signal integrity issues.
- The INT pin is active-low with internal pull-up on the Pico (configured in firmware).

## 4. LED Driver & LDR Sensor Circuit (per node)

Each node has the same LED/LDR circuit from Phase 1:

### A) LED Driving Circuit

GP15
(PWM)

47 Ohm

LED

GND

### B) LDR Illuminance Reading Circuit

3V3 (VCC)

LDR

GP26 / A0
(Analog Input)

10 kOhm

10 uF

GND

### LED/LDR Pin Summary:

GP15 (pin 20) | LED PWM output (via 47 Ohm resistor)
GP26/A0 (pin 31) | LDR analog input (voltage divider midpoint)
3V3 (pin 36) | LDR circuit power supply
GND (pin 23 or 28) | Common ground for LED and LDR

## 5. CAN-BUS Wiring Between Nodes

CAN-BUS uses a linear bus topology. Connect all CANH together and all CANL together.

### CAN-BUS Wiring Steps:

1. Connect all three MCP2515 CANH pins together using a single wire (red recommended).
2. Connect all three MCP2515 CANL pins together using a single wire (yellow recommended).
3. Enable the termination jumper on Node 1 and Node 3 (the two END nodes).
4. Remove/disable the termination jumper on Node 2 (the MIDDLE node).
5. Keep CAN-BUS wires as short as possible. Use twisted pair if available.
6. Ensure all nodes share a common GND (they do if powered from same USB hub).

### 6. Termination Resistors

CAN-BUS requires 120 Ohm termination resistors at each end of the bus to prevent signal reflections. The Joy-It MCP2515 modules have a built-in 120 Ohm resistor that can be activated via a jumper.

For a 3-node setup:
Node 1 (end): Termination jumper ON
Node 2 (middle): Termination jumper OFF
Node 3 (end): Termination jumper ON

If you only have 2 nodes: both should have termination ON.
If the jumper is a solder bridge, you may need to solder/desolder it.

### 7. Troubleshooting

No CAN communication:
Check SPI wiring (especially MISO/MOSI not swapped). Verify 3.3V power. Intermittent errors:
Check termination. Both ends must have 120 Ohm. Check wire connections. Only hub sees messages:
Other nodes may not have booted. Check CAN_H/CAN_L continuity.
Node not discovered:
Verify MCP2515 crystal is 16 MHz (matches firmware setting MCP_16MHZ). SPI not working:
Ensure using SPI1 pins (GP16-19), not SPI0 (GP0-3).

## 8. Complete Pin Assignment — All Connections per Node

Pico Pin | GPIO | Function | Connects To | Notes
Pin 20 | GP15 | PWM Output | LED (via 47 Ohm) | 30 kHz, 12-bit
Pin 31 | GP26/A0 | ADC Input | LDR divider midpoint | 12-bit ADC
Pin 21 | GP16 | SPI1 RX | MCP2515 SO (MISO) | Data from CAN
Pin 22 | GP17 | SPI1 CSn | MCP2515 CS | Chip select
Pin 24 | GP18 | SPI1 SCK | MCP2515 SCK | SPI clock
Pin 25 | GP19 | SPI1 TX | MCP2515 SI (MOSI) | Data to CAN
Pin 26 | GP20 | Digital In | MCP2515 INT | Interrupt (low)
Pin 36 | 3V3 | Power | MCP2515 VCC + LDR VCC | 3.3V rail
Pin 23 | GND | Ground | MCP2515 GND | Common GND
Pin 28 | GND | Ground | LED GND + LDR GND | Common GND
USB | — | Serial | PC (hub node only) | 115200 baud

## 9. Assembly Checklist

[ ] Each Pico has LED circuit on breadboard (GP15 -> 47 Ohm -> LED -> GND)
[ ] Each Pico has LDR circuit on breadboard (3V3 -> LDR -> A0 junction -> 10k -> GND, 10uF cap) [ ] Each Pico connected to MCP2515 via 7 jumper wires (SPI + power)
[ ] All 3 MCP2515 CANH pins connected together
[ ] All 3 MCP2515 CANL pins connected together
[ ] Termination ON for end nodes (1 and 3), OFF for middle node (2) [ ] All GND rails connected together
[ ] Hub Pico (any node) connected to PC via USB
[ ] LED and LDR pointing INTO the box (not at each other directly)
[ ] Box interior lined with white paper for light reflection
[ ] Components secured with double-face tape (NOT breadboard sticker) [ ] Upload firmware to all 3 Picos (hold BOOTSEL, connect USB, upload)

After assembly, run: python scripts/test_boot.py
This will verify all 3 nodes are discovered and communicating.
