joao-tecnico-chad/SCDTR-project/Local Luminaire Controller/report/figures/step_response_ki011.png

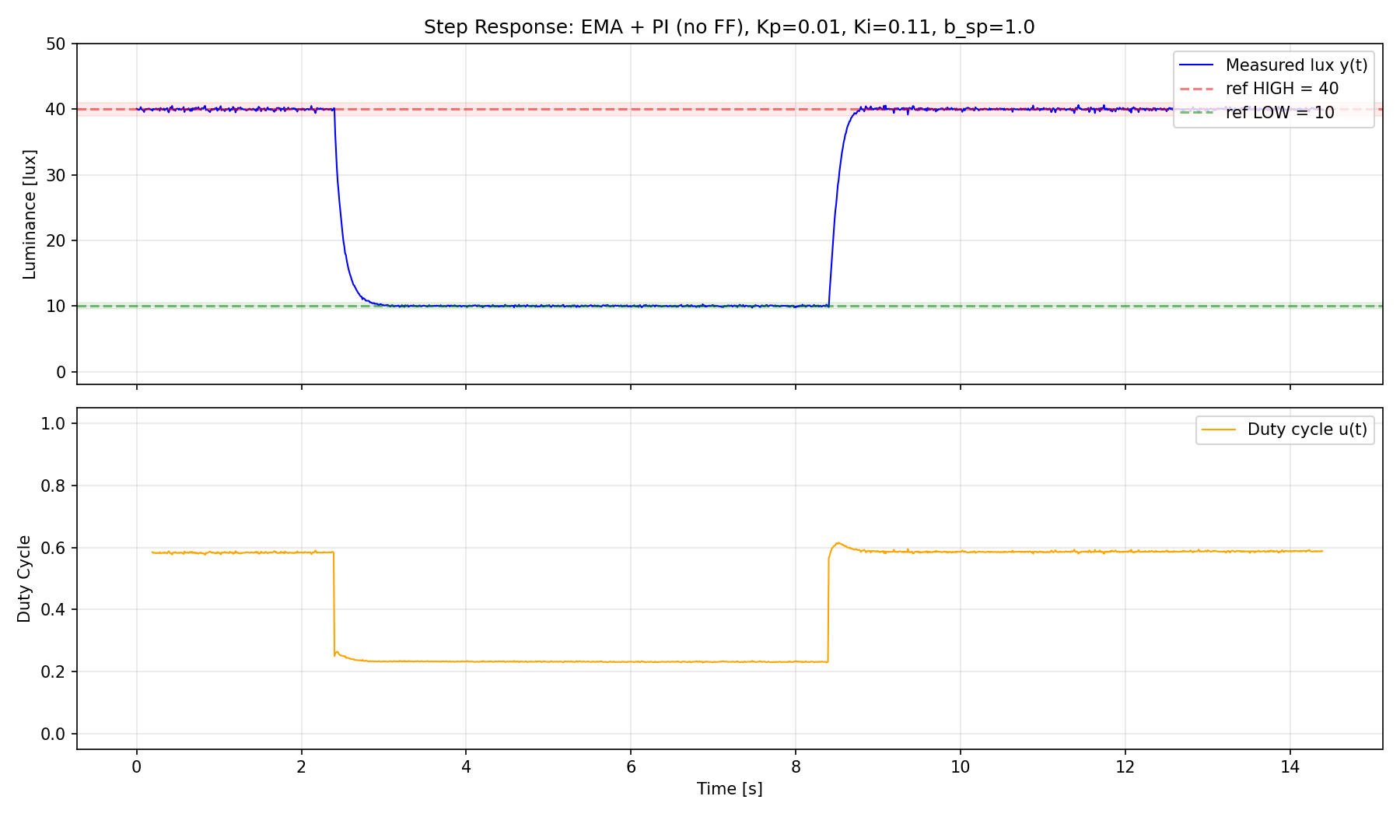
Local Luminaire Controller/report/figures/step_response_ki011.png
