joao-tecnico-chad/SCDTR-project/results/step_response.png

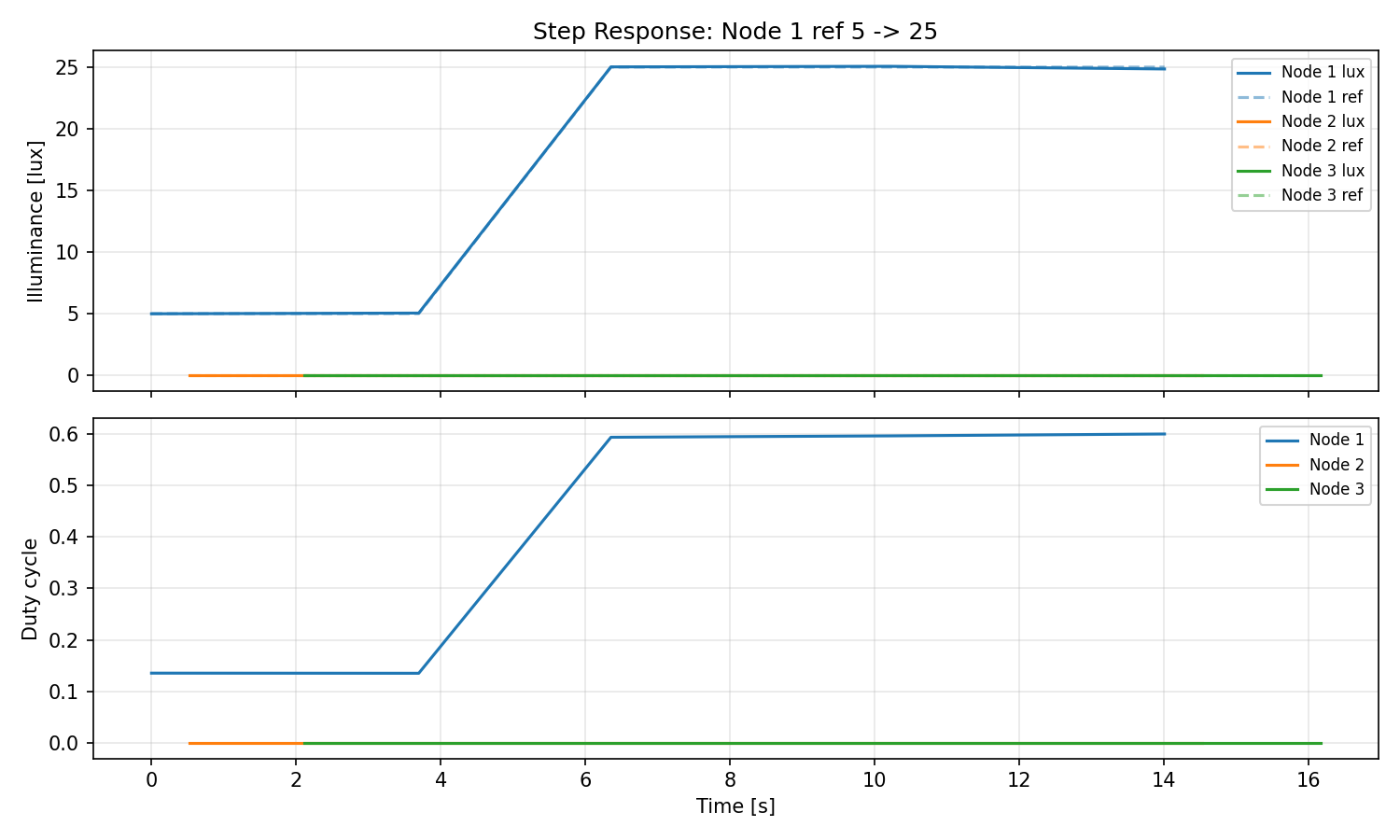
results/step_response.png
