joao-tecnico-chad/SCDTR-project/results/disturbance_rejection.csv

time_s | node_id | lux | duty | ref
0.0 | 1 | 19.837 | 0.4139194139194139 | 20.0
0.88 | 2 | 19.99 | 0.15262515262515264 | 20.0
1.762 | 3 | 19.994 | 0.22564102564102564 | 20.0
2.646 | 1 | 20.065 | 0.40073260073260075 | 20.0
3.531 | 2 | 19.975 | 0.15067155067155066 | 20.0
4.4 | 3 | 20.011 | 0.22612942612942613 | 20.0
5.275 | 1 | 20.001 | 0.4146520146520147 | 20.0
6.159 | 2 | 19.944 | 0.1514041514041514 | 20.0
7.034 | 3 | 19.991 | 0.2258852258852259 | 20.0
7.914 | 1 | 19.912 | 0.40244200244200246 | 20.0
8.793 | 2 | 19.974 | 0.1509157509157509 | 20.0
9.665 | 3 | 20.025 | 0.22564102564102564 | 20.0
10.548 | 1 | 19.954 | 0.4148962148962149 | 20.0
11.426 | 2 | 20.014 | 0.1514041514041514 | 20.0
12.306 | 3 | 19.996 | 0.22564102564102564 | 20.0
13.188 | 1 | 20.039 | 0.4039072039072039 | 20.0
14.074 | 2 | 19.991 | 0.15213675213675212 | 20.0
14.951 | 3 | 19.997 | 0.2258852258852259 | 20.0
15.826 | 1 | 19.986 | 0.4148962148962149 | 20.0
16.71 | 2 | 18.089 | 0.26153846153846155 | 20.0
17.585 | 3 | 19.926 | 0.36043956043956044 | 20.0
18.463 | 1 | 19.682 | 0.6981684981684981 | 20.0
19.334 | 2 | 19.939 | 0.23882783882783884 | 20.0
20.215 | 3 | 19.984 | 0.37216117216117217 | 20.0
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
