joao-tecnico-chad/SCDTR-project/results/algorithm_comparison.png

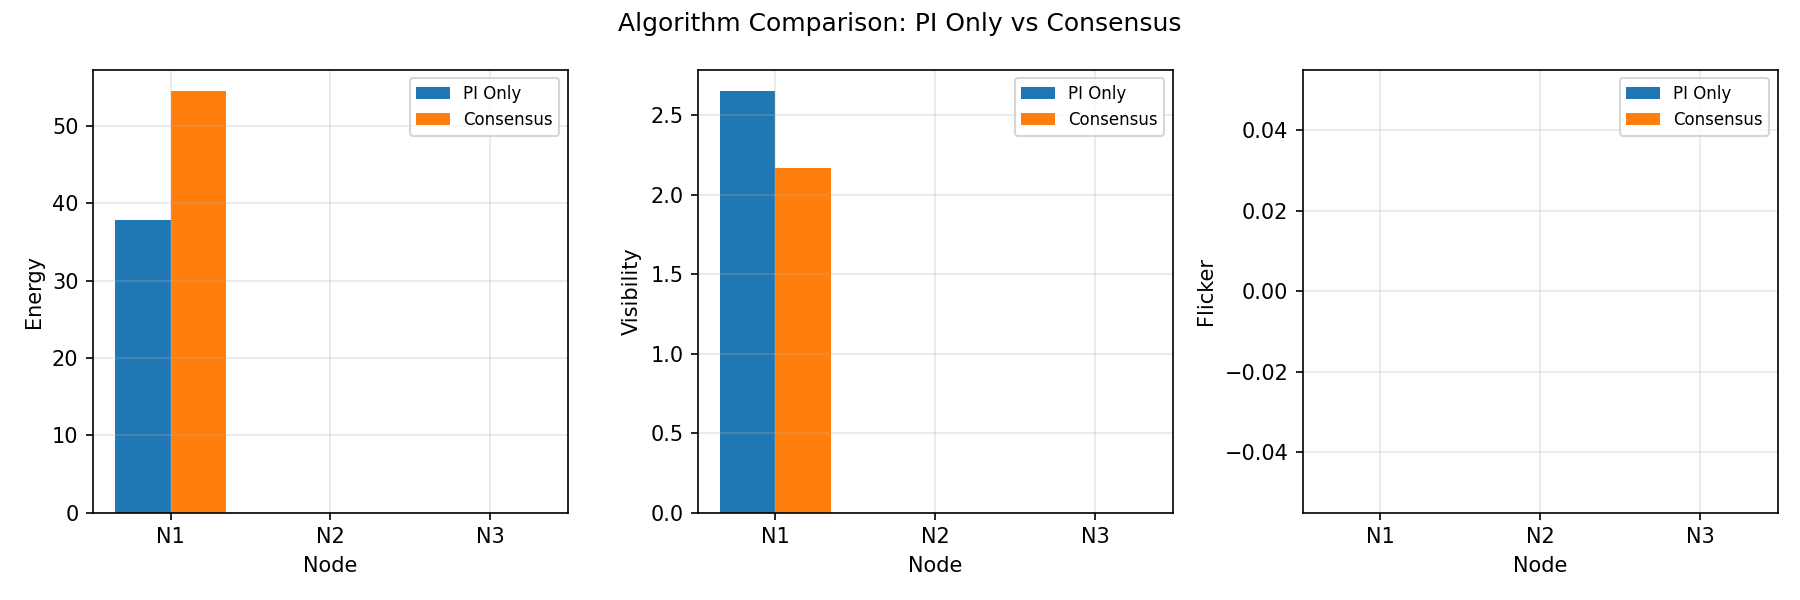
results/algorithm_comparison.png
