joao-tecnico-chad/SCDTR-project/(commit log)

2026-03-20 Initial commit: Phase 1 (local controller) + Phase 2 (distributed controller)
    Phase 1: Local luminaire PI controller with LUX calibration, anti-windup,
    serial command interface, and Python test scripts.
    Phase 2: Distributed cooperative controller with CAN-BUS networking,
    3 optimization algorithms (consensus, dual decomposition, ADMM),
    hub function, network boot/calibration, and full test suite.
    [data_antiwindup.csv, data_feedback.csv, data_step.csv]
2026-03-26 Add distributed calibration firmware
2026-04-02 Add CAN_ORDER multicore CAN calibration project
2026-04-09 Add test scripts, results, and disturbance rejection test
    - Data collection script (collect_data.py) for automated 3-node testing
    - Disturbance rejection test script with interactive open/close box timing
    - Algorithm comparison results (PI, Consensus, ADMM, Dual Decomposition)
    - Step response with feedforward, occupancy change, cost comparison data
    - Disturbance rejection CSV and plot showing controller response to box open/close
    - MCP2515 ADC pin test sketch
    - Distributed calibration firmware
    [alg_comparison_equal.csv, alg_comparison_unequal.csv, algorithm_comparison.csv, cost_comparison.csv, disturbance_rejection.csv, occupancy_change.csv, step_response.csv, step_response_ff.csv]
2026-04-09 Add metrics reset, fix consensus, write Phase 2 report
    Firmware changes:
    - Add RM command to reset energy/visibility/flicker metrics independently
    - Fix consensus to check all nodes' constraints (not just own)
    - Lower CONS_RHO from 10 to 2 for better cost sensitivity
    - Add calibration timing output
    - Add startMs field to CalibrationContext
    Report:
    - Complete Phase 2 report with all sections filled in
    - Gain matrix table, calibration timing, algorithm formulations
    - Results: equal/unequal costs, step response, occupancy, disturbance
    - Fix IST logo path
    Test improvements:
    - Equal 20s measurement time for all algorithms
    - Fast single-node polling for step response and occupancy tests
    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
    [alg_comparison_equal.csv, alg_comparison_unequal.csv, occupancy_change.csv, step_response_ff.csv]
2026-04-11 Update test results: fresh model validation, programmatic disturbance, system photos
    - Reran model validation sweep for consistent K matrix values
    - Added programmatic disturbance test (Node 2 forced to 0.8, sub-second recovery)
    - Added system photos (top view + interior with 3D-printed fixtures)
    - Updated algorithm comparison and step response data
    [alg_comparison_equal.csv, alg_comparison_unequal.csv, disturbance_programmatic.csv, model_validation.csv, occupancy_change.csv, step_response_ff.csv]
2026-04-11 Polish report: 3 authors, system photos, diagrams, programmatic disturbance
    - Added 3-author header (Joao Rocha, Ricardo Gaspar, Diogo Costa)
    - Added calibration state machine TikZ flowchart
    - Added wakeup sequence TikZ diagram
    - Added programmatic disturbance test section (sub-second recovery)
    - Updated K matrix and R² values from fresh calibration run
    - Expanded CAN table with direction and payload columns
    - Added algorithm robustness and future work sections
    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
2026-04-12 Add thorough comments to modular firmware + help command
    - Added serial 'help' command listing all available commands
    - Detailed inline comments in all .h files for oral presentation
    - Documented LDR-to-lux pipeline, FIFO protocol, CAN message payloads,
    PI controller math, algorithm steps, calibration state machine
    - Comments-only changes, no logic modified
2026-04-12 Add study notes for oral exam preparation
    11 markdown files covering: project overview, hardware, linear model,
    CAN bus, dual-core architecture, PI controller, distributed algorithms,
    results analysis, code walkthrough, and exam cheat sheet.
    Includes real measured data, step-by-step math, 25+ Q&A pairs.
2026-04-12 Trim report to <1000 words (currently ~700), remove appendix
2026-04-12 Fix 4 comment inaccuracies: specify rho values, correct projection description, add TT value
    [admm.h, consensus.h, control.h]
2026-04-12 Add 45kHz PWM frequency, update authors to all 3 members
2026-04-12 Auto-config from flash UID, fix calibration timing, query labels, 6dp metrics, gain exchange fix
    [CAN_ORDER_modular.ino, calibration.h, can_protocol.h, can_transport.h, consensus.h, hardware_config.h, serial_ui.h, terminal.py]
2026-04-12 Fix flicker bug, auto-config from flash UID, query labels, 45kHz PWM
    - Fix: flicker was always 0 because duty was measured BEFORE PI update.
    Moved flicker calculation after setLedPwm() so it compares new vs old duty.
    - Auto-config: read Pico flash UID at boot, skip manual ID prompt
    - Query labels: responses now show "// illuminance [lux]" etc.
    - Boot messages: "Wakeup complete", "Starting calibration...",
    "Calibration complete in Xms", "Gain exchange complete"
    - 6 decimal places for E/V/F metrics
    - 45kHz PWM frequency (Ricardo's fix)
    - Terminal script shows pending boot messages
    [control.h, uid_reader.ino]
2026-04-12 Update flicker in report (~0.0003), fix 6dp for remote metric queries
    [can_protocol.h]
2026-04-12 Add demo script, comprehensive test, wiring guide, course PDFs
2026-04-13 Update study notes: 45kHz PWM, flicker ~0.0003, auto-config from UID
